BellaLee2007/tinggu/docs/hardware_pinout.md

# 硬件引脚与实物接口

本表于 2026-09-14 更新为当前 ESP32-S3 实物接口；经典 ESP32 的旧 GPIO34/21/22 接法不适用于此版本。物理接线以
`docs/tonight_bringup_wiring.md` 的节点表为准；任何改线都必须同步更新两份文档。

| 模块 | 型号 | ESP32接口 | 电压/供电 | 当前状态与备注 |
|---|---|---|---|---|
| 主控 | ESP32-S3（Arduino选择 ESP32S3 Dev Module） | USB串口 | USB/5 V | USB供电；模拟前端使用ESP32的3.3 V |
| 压电模拟输出 | 压电片＋BAT54S＋TLV9062 | GPIO4 / ADC1_CH3 | GPIO4目标范围0～3.3 V | 100 kΩ限流、BAT54S钳位、1.65 V偏置、1倍缓冲、2.2 kΩ串联保护；不使用输出分压 |
| IMU | 模块丝印MPU-6050，实测WHO_AM_I=0x70（MPU-6500兼容芯片） | SDA=GPIO17，SCL=GPIO15 | 3.3 V | 地址0x68；INT/XDA/XCL不接；固件按MPU-6500报告 |
| 模拟前端 | TLV9062（芯片第二行`ZFT9G3`为追踪码） | 输出经2.2 kΩ串联接GPIO4 | 3.3 V | 8脚=3.3 V、4脚=GND；B路缓冲基准，A路缓冲压电信号；轨到轨输入/输出 |
| ARM按钮 | 待选 | 默认禁用，`ARM_BUTTON_PIN=-1` | 3.3 V逻辑 | 可只使用C#或串口ARM |
| OLED | SSD1306，128×64，四针I²C | SDA=GPIO8，SCL=GPIO9（Wire1） | VCC=3.3 V，GND共地 | 独立于MPU总线；自动探测0x3C/0x3D；端侧固件已实现，未接不阻断采集 |
| 电磁撞针 | 型号待确认 | **不连接ESP32** | 独立电源和控制器 | 记录电压、电流、档位、冲程、头部尺寸和固定距离 |

## 硬件同学必须补齐

- ESP32、MPU、OLED和压电调理板的完整丝印照片；
- 压电ADC静止偏置、空闲噪声、轻敲峰值和是否削顶；
- 撞针控制器的档位或脉宽设置，以及每次实验是否完全相同；
- MPU方向、安装胶层、线长、压电位置和铁板尺寸；
- 撞针通电但不接触铁板时，压电是否因电磁干扰误触发。
