BellaLee2007/tinggu/docs/decision_log.md

# 技术决策记录

| 日期 | 决策 | 原因 | 后续验证 |
|---|---|---|---|
| 2026-08-28 | 撞针由外部按钮/控制器触发，ESP32不控制其功率回路 | 最终敲击结构尚未冻结，优先降低嵌入式和电气风险 | 第3天前冻结型号、安装位置和激励设置 |
| 2026-08-28 | 保留验证固件，另建`tinggu_edge_runtime` | 防止双核和端侧算法破坏已验证的数据链路 | 两套固件分别编译和验收 |
| 2026-08-28 | Core 0采集、Core 1处理，使用两个固定缓冲区和Queue传递所有权 | 保证DMA采样不被FFT、串口和显示阻塞 | 检查任务核心、队列溢出和丢点率 |
| 2026-08-28 | 模型未交付前固定返回`MODEL_UNTRAINED` | 禁止用臆造阈值输出松紧结论 | golden vectors通过后才能替换模型接口 |
| 2026-08-28 | 初始512点FFT，采样率从2/5/10/20 kHz实测选择 | 报告要求根据实际频段校准 | 主峰<0.4采样率且相邻采样率主频偏差<2% |
| 2026-09-14 | 新增20260913全量清洗数据决策树的独立候选移植，暂不切换正式LDA；采样与阈值保持原样 | 新树为14特征，仓库缺对应特征实现、明确映射和golden vectors，禁止猜测接入 | 树遍历2087组与12叶路径测试通过、ESP32-S3编译通过；端到端验证待补交代码，候选保持MODEL_UNTRAINED |
| 2026-09-14 | OLED冻结SSD1306 128×64四针I²C，3.3V，Wire1 SDA8/SCL9；仅loop刷新、结果保持至下一次测量 | MPU仍独占Wire SDA17/SCL15；屏幕缺失不影响采集；不改变模型、特征、阈值和采样率 | ESP32-S3编译及显示状态检查；接屏实测待完成 |
| 2026-09-14 | 核对92d65d5训练脚本，确认树类别映射并将候选推断输入转换float32；仍不切换正式模型 | 新脚本只读取预计算14维特征表，缺波形提取程序与golden；禁止猜测公式 | 2087组树遍历测试通过；等待生成training_dataset_20260911.csv的脚本 |
| 2026-09-14 | 暂不启用新树：新增特征脚本ab53542与现有模型/本地波形不能复现节点分布 | 289条回放命中116条；根节点左分支应124条实际33条；Python/C++分类一致，排除树移植差异 | 已生成逐事件14维特征及节点对照；等待实际训练特征表与配套版本，不更改正式LDA/OLED |
| 2026-09-15 | 采用4859fa6原始train_waveform_14features脚本，切换正式端侧为14维自定义double树，保留OLED | 289条23节点样本数及多数类全匹配；原始波形14维Python/C++一致、分类0差异；旧250Hz/300ms脚本不配套 | 已完成主机golden及EventBuffer适配验证，上电加入真实波形自检；实物测量待验收 |
| 2026-09-15 | 硬锁2kHz压电/1kHz MPU，整段变长事件1400–2600行、Hann后补零至最多4096，100Hz分频；取代240ms LDA特征 | 原始模型对事件长度和频域定义敏感，旧固定900ms不可直接复用；触发按V16三活动样本确认、最小阈值20，50ms双传感器安静后允许结束 | CSV原数据不修改；现场核对#MODEL_FEATURES及MPU丢点；MPU6500 ACCEL_CONFIG2=0x01与采集版一致 |
| 2026-09-15 | 从已完全匹配的训练波形恢复叶节点各类计数，沿用三敲概率均值与0.50门限 | 原JSON只有pred+n；恢复计数经全部节点n和argmax验证，不重训、不虚构100%置信度 | 单元测试包含三类平票→UNCERTAIN、单一路无效→MODEL_UNTRAINED；频率并非独立测试准确率 |
