BellaLee2007/tinggu/tools/TingguSignalWorkbench/使用说明.md

# 听固双传感器敲击验证工作台

这套工具只判断压电片和 MPU-6050 的信号是否清晰、完整、可重复，不直接给出螺丝“松/紧”结论。

## 第一次使用

1. 打开 `firmware/tinggu_signal_validator/tinggu_signal_validator.ino`，只检查文件最上面的 `PIEZO_ADC_PIN`、`MPU_SDA_PIN`、`MPU_SCL_PIN`。地址保留 `0` 即可自动检测。
2. 在 Arduino IDE 中选择普通 ESP32 和对应串口，上传固件。
3. 关闭 Arduino 串口监视器，因为一个串口不能同时被两个程序占用。
4. 双击 `TingguSignalWorkbench.exe`，选择 COM 口并点“连接”。
5. 上电标定的一秒内不要碰铁板。如果刚才动过铁板，等待静止后点“重新标定”。
6. 填写试件编号、松紧描述和敲击方式，点“下一次采集 / ARM”。
7. 状态显示“已布防，可以敲击”后，只敲一次。工具会等待约 0.9 秒，接收数据后冻结两张曲线并自动导出 CSV。
8. 看完本次结果后，再点一次“下一次采集 / ARM”，然后进行下一次敲击。

“手动采集”用于不敲击也强制抓取一秒数据，主要检查静止噪声。图表可框选缩放，双击恢复全图。

## 导出位置

- 单次波形：`data/signal_validator/event_*.csv`
- 每次一行的指标汇总：`data/signal_validator/summary.csv`

单次 CSV 保留 2000 Hz 时间轴。MPU 只在真正读取到的 1000 Hz 行写值，其他行留空，不进行伪插值。

## 质量判定的含义

- 压电默认要求：不饱和，SNR ≥ 10 dB。
- MPU 默认要求：不饱和，丢点率 < 1%，SNR ≥ 6 dB。
- 两路同时通过才显示“双传感器信号有效”。阈值可在界面修改。
- “窗口截断”表示 900 ms 后振动仍未衰减到噪声阈值以下，需要检查安装、环境干扰，或以后增大采集窗口。

标准化敲击结构完成前，主频、持续时间等结果只能用于确认传感器结构是否可靠，不能据此下松紧结论。
