BellaLee2007/tinggu/firmware/releases/oled_ssd1306_20260914/验证记录.md

# 验证记录

- ESP32-S3，fqbn=esp32:esp32:esp32s3；U8g2=2.36.19。
- 正式端侧编译成功：395892 bytes flash，64992 bytes全局RAM。
- 独立OLED验屏编译成功：351604 bytes flash，24712 bytes全局RAM。
- 主机模拟测试通过：结果保持、迟到PROCESSING消息不覆盖结果、启动新测量清除旧结果、仅变化刷新、屏幕掉线停用显示。
- 两个程序的display_interface.h内容一致；打包源码与编译源码一致。
- 未烧录开发板，未进行实物屏幕/传感器同时工作的验收。
- 正式模型、特征、采样率、质量阈值未改变。
