BellaLee2007/tinggu/firmware/releases/oled_ssd1306_20260914/tinggu_edge_runtime/README.md

# Tinggu edge runtime

这是比赛端侧固件骨架，不替代已经验证可用的 `tinggu_signal_validator`。

## 当前已实现

- 底层 `adc_continuous` DMA保留每个压电ADC原始点；
- MPU-6050原始I2C驱动；
- 采集任务固定到Core 0，分析任务固定到Core 1；
- 两个固定事件缓冲区和FreeRTOS Queue所有权传递；
- 三次外部敲击组成一次测量；
- 质量门控、512点Hann FFT、`f1/tau/Eratio/C`；
- 240 ms固定截窗、40项频谱/时频/相干特征和三分类LDA模型；
- 三次敲击分别推理，再平均三类概率输出最终结果；
- 每敲发送101点降采样预览，供V13桌面端显示波形，不阻塞下一次采集；
- 模型和OLED的独立替换接口；
- 撞针完全外部触发，没有撞针控制GPIO。

## 当前硬件接口

1. 当前ESP32-S3接口为 `PIEZO_ADC_PIN=4`（ADC1_CH3）、`MPU_SDA_PIN=17`、`MPU_SCL_PIN=15`；完整模拟前端见 `docs/tonight_bringup_wiring.md`。
2. 上电标定的一秒内保持铁板静止。
3. 串口发送 `ARM_MEASUREMENT`。每一敲先输出 `PREPARE_STRIKE` 并倒计时2秒，看到 `STRIKE_NOW` 后再按撞针；每一敲单独有5秒等待时间。
4. 当前模型为 `spectral_lda40_20260903`，类别为 `TIGHT/MEDIUM/LOOSE`；最终置信度低于0.50时输出 `UNCERTAIN`。
5. `#STRIKE_RESULT`把满足质量门控的敲击标为A级并计入；未达到A级的尝试立即丢弃并重试当前序号，直到累计3次A级敲击才输出结果。`#HIT_MODEL`输出单敲调试概率，`#MEASUREMENT_RESULT`输出三次A级敲击概率平均后的类别。
   V13桌面端还会解析`#PREVIEW_BEGIN/#PREVIEW_POINT/#PREVIEW_END`，显示每敲降采样波形。
6. 当前模型的同日分组验证准确率约81.8%，仍必须用下一次独立实验验证，不能把它当作最终准确率。
7. `display_interface.h` 已实现 SSD1306 128×64 I²C OLED；安装 U8g2 库（本机验证版本2.36.19），SDA=GPIO8、SCL=GPIO9、VCC=3V3、GND共地，自动探测0x3C/0x3D。使用Wire1独立总线，仅loop执行屏幕传输。接线和测试见 `docs/oled_setup.md`。

## 串口命令

- `ARM_MEASUREMENT`：开始等待三次敲击；
- `ABORT`：中止本次测量；
- `RECALIBRATE`：重新静置标定；
- `STATUS`：输出任务核心、状态、采样率和传感器状态。
