BellaLee2007/tinggu/models/20260913/confusion_matrix_full.png

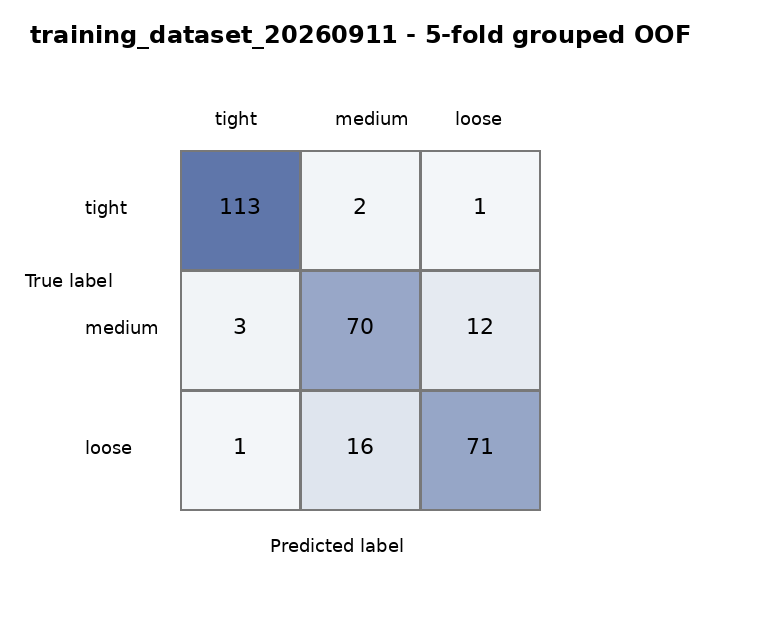
models/20260913/confusion_matrix_full.png
