BellaLee2007/tinggu/models/20260913/confusion_matrix_perfect_strict.png

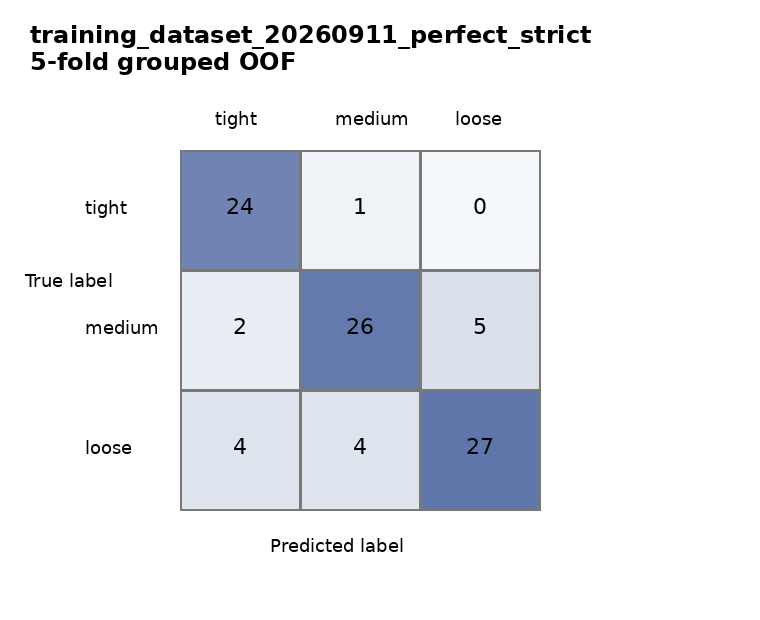
models/20260913/confusion_matrix_perfect_strict.png
