BellaLee2007/tinggu/firmware/releases/oled_ssd1306_20260914/tinggu_edge_runtime/model_parameters.h

#pragma once

// Generated from models/20260903/spectral_lda40_export.json.
// Feature extraction order is frozen; do not reorder these arrays by hand.
static const char TINGGU_MODEL_VERSION[] = "spectral_lda40_20260903";
static const unsigned TINGGU_MODEL_FEATURE_COUNT = 40;
static const unsigned TINGGU_MODEL_CLASS_COUNT = 3;
static const float TINGGU_MODEL_CONFIDENCE_THRESHOLD = 0.50f;

static const char *const TINGGU_MODEL_FEATURE_NAMES[40] = {
  "rm_spec_band_150_200",
  "rm_spec_band_200_250",
  "rm_spec_band_250_400",
  "rm_spec_band_60_100",
  "rm_spec_cep_03",
  "rm_spec_cep_06",
  "rm_spec_cep_08",
  "rm_spec_cep_09",
  "rm_spec_cep_15",
  "rm_spec_cep_16",
  "rm_tf_t0_100_150",
  "rm_tf_t0_150_200",
  "rm_tf_t0_200_250",
  "rm_tf_t0_5_30",
  "rm_tf_t0_60_100",
  "rm_tf_t1_150_200",
  "rm_tf_t1_250_400",
  "rm_tf_t1_60_100",
  "rm_tf_t2_150_200",
  "rp_spec_band_100_150",
  "rp_spec_band_150_200",
  "rp_spec_band_300_500",
  "rp_spec_cep_02",
  "rp_spec_cep_03",
  "rp_spec_cep_05",
  "rp_spec_cep_07",
  "rp_spec_cep_09",
  "rp_spec_cep_19",
  "rp_tf_t1_100_150",
  "rp_tf_t1_250_500",
  "rp_tf_t2_100_150",
  "rp_tf_t2_5_30",
  "rp_tf_t3_100_150",
  "rp_tf_t3_150_250",
  "rp_tf_t3_5_30",
  "rp_tf_t3_60_100",
  "xfer_coherence_30_60",
  "xfer_logratio_100_150",
  "xfer_logratio_150_200",
  "xfer_logratio_60_100",
};

static const float TINGGU_MODEL_IMPUTER_MEDIAN[40] = {
  0.086686891f, 0.0577367906f, 0.162263728f, 0.234962171f,
  0.885562861f, -0.932165321f, 0.0266282279f, 0.813759559f,
  -0.351437795f, -0.399328163f, 0.116980171f, 0.0944962775f,
  0.0478989077f, 0.0152079045f, 0.228174496f, 0.0486212098f,
  0.157310245f, 0.196841061f, 0.0204528909f, 0.0258772888f,
  0.0282733628f, 0.119010446f, 2.66366889f, 3.63617525f,
  3.59083403f, 1.49292455f, 1.04893707f, -0.105270977f,
  0.0149367788f, 0.121634086f, 0.0178458241f, 0.113140785f,
  0.0130630471f, 0.0185584314f, 0.126587095f, 0.0913513555f,
  0.449819847f, -3.59211676f, -3.76983623f, -3.26365404f,
};

static const float TINGGU_MODEL_SCALER_MEAN[40] = {
  0.111908653f, 0.0760772969f, 0.203329908f, 0.293470724f,
  0.23112501f, -1.09361717f, 0.0983615209f, 1.18083086f,
  -0.542089193f, -0.53712606f, 0.142536822f, 0.113977528f,
  0.0730958253f, 0.064284369f, 0.263709237f, 0.0859672178f,
  0.216987711f, 0.272922653f, 0.0438370508f, 0.0332320034f,
  0.0305933355f, 0.131608067f, 2.84639144f, 3.71637307f,
  3.88418556f, 1.46231196f, 1.16692625f, -0.114095108f,
  0.0237640501f, 0.133206789f, 0.02341767f, 0.130237838f,
  0.015734129f, 0.0223009505f, 0.13672451f, 0.107761989f,
  0.463087407f, -3.72535789f, -3.87210005f, -3.50940092f,
};

static const float TINGGU_MODEL_SCALER_SCALE[40] = {
  0.105139601f, 0.0685172174f, 0.166803748f, 0.203949412f,
  4.01826612f, 2.37360316f, 2.12298831f, 2.5260905f,
  1.71148752f, 1.66486843f, 0.0979880334f, 0.100957166f,
  0.0747222344f, 0.102733162f, 0.155313591f, 0.116668947f,
  0.202746527f, 0.229611797f, 0.0568162581f, 0.0275284892f,
  0.0189503074f, 0.0849177283f, 2.81861408f, 2.79210318f,
  2.77238738f, 2.09935435f, 1.78792176f, 1.44485294f,
  0.0278976613f, 0.0956238431f, 0.022885704f, 0.0982200815f,
  0.0137451118f, 0.0211826244f, 0.0963886115f, 0.0825934304f,
  0.229888637f, 1.26464678f, 1.28878656f, 1.11659362f,
};

static const float TINGGU_MODEL_COEFFICIENTS[120] = {
  0.46241487f, -0.332592727f, -0.02496929f, -0.539963712f, -1.08197829f,
  -0.490729656f, -0.460305897f, 0.737940808f, -0.25063013f, -0.181574244f,
  0.0789907556f, 0.638619076f, -0.797643809f, -0.261794486f, 0.511676948f,
  -0.0519024462f, -0.462716894f, 0.782012553f, 0.0451461219f, -0.0313384308f,
  -0.326158711f, -0.0911190641f, 0.501837543f, -0.167329656f, 0.139568616f,
  -0.0259694659f, 0.205474748f, 0.28731498f, -0.340862324f, 0.117339335f,
  -0.124252065f, -0.128099291f, 0.0760609597f, -0.297144005f, 0.203508443f,
  0.0217206666f, -0.194011783f, 0.20344896f, 0.126800114f, -0.485492804f,
  -0.148614056f, 0.371899918f, -0.0381624615f, 0.355513825f, 0.193816657f,
  0.487030597f, 0.287243771f, -0.448637055f, 0.116637869f, 0.11861136f,
  -0.200462672f, -0.245875772f, 0.149820449f, 0.250678165f, -0.250328465f,
  -0.0795331978f, 0.145401489f, -0.465636136f, -0.094114764f, -0.0292748029f,
  0.147022928f, -0.175578819f, -0.101607646f, -0.384875321f, 0.0814374747f,
  0.315730873f, -0.119986198f, -0.184249524f, -0.128114071f, 0.0405283067f,
  -0.133616053f, -0.151660246f, 0.0680045893f, 0.274917411f, 0.0686933548f,
  0.0479844506f, -0.184333473f, 0.0238173516f, -0.372372247f, 0.340369135f,
  -0.330806934f, -0.0375709141f, 0.0658792396f, 0.197101009f, 0.934049009f,
  0.00870426536f, 0.184473555f, -0.308067672f, 0.141780372f, 0.0672542284f,
  0.125500599f, -0.414620455f, 0.681377194f, 0.0141485956f, -0.276765026f,
  0.137154902f, 0.334463707f, -0.336648875f, 0.050461003f, 0.0633240393f,
  0.189459563f, 0.278162344f, -0.421049275f, 0.57573121f, -0.231140675f,
  -0.300979983f, -0.0909086389f, -0.10999196f, 0.490924593f, -0.165281601f,
  0.269310935f, 0.292107432f, -0.150524194f, 0.0260488756f, -0.284997002f,
  -0.0726807721f, 0.395250136f, -0.238281304f, 0.254042315f, 0.155678f,
};

static const float TINGGU_MODEL_INTERCEPTS[3] = {
  -4.01549934f, -2.02661635f, -2.62603818f,
};
