BellaLee2007/tinggu/firmware/tinggu_edge_runtime/model_selftest.h

#pragma once
#include "waveform_features.h"
// GENERATED board startup golden from one actual training waveform, source extraction unchanged.
static const char TINGGU_SELFTEST_SOURCE[]="event_0002_tight_20260911_160233_309.csv";
static const uint16_t TINGGU_SELFTEST_PIEZO[]={1913,1917,1927,1934,1939,1943,1941,1949,1945,1946,1944,1949,1947,1949,1943,1939,1933,1929,1930,1918,1917,1915,1911,1909,1913,1913,1912,1913,1911,1912,1912,1913,1911,1912,1909,1919,1915,1913,1914,1915,1910,1915,1925,1935,1933,1933,1941,1949,1941,1949,1949,1949,1945,1943,1943,1939,1932,1932,1928,1918,1919,1913,1913,1909,1909,1911,1907,1914,1913,1911,1912,1913,1915,1913,1916,1916,1912,1916,1911,1915,1913,1914,1917,1926,1931,1940,1941,1945,1945,1947,1949,1949,1943,1947,1945,1933,1938,1935,1929,1919,1917,1917,1913,1903,1913,1913,1908,1909,1909,1909,1916,1911,1912,1913,1915,1911,1910,1913,1913,1913,1916,1918,1928,1928,1935,1939,1940,1944,1951,1944,1949,1947,1949,1947,1945,1937,1935,1931,1929,1917,1913,1912,1911,1907,1913,1912,1909,1916,1912,1913,1912,1911,1915,1913,1911,1913,1912,1911,1911,1911,1917,1917,1928,1928,1940,1935,1944,1943,1943,1942,1949,1945,1949,1944,1946,1939,1938,1931,1930,1917,1917,1917,1913,1909,1914,1915,1911,1911,1919,1910,1903,1916,1919,1911,1915,1915,1917,1799,1799,2159,1443,2039,2019,1547,1373,2028,1885,1834,2301,2351,2255,2715,2586,1991,2183,1915,1583,1720,1801,1581,1715,1867,1749,1764,1911,1769,1682,1976,1771,1961,2220,2095,1976,2087,1899,1737,1785,1871,1822,1911,1919,1829,1804,1813,1773,1847,1862,1885,2089,2237,2272,2279,2235,1965,1909,1818,1780,1775,1813,1782,1774,1829,1815,1829,1867,1906,2005,2077,2167,2165,2173,2085,1995,1864,1759,1711,1757,1775,1811,1853,1877,1873,1901,1949,1965,1989,2015,2027,2057,2045,203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
struct TingguStartupGolden : TingguWaveform14::Waveform {
 unsigned count()const override{return sizeof(TINGGU_SELFTEST_PIEZO)/sizeof(TINGGU_SELFTEST_PIEZO[0]);}
 double timeMs(unsigned i)const override{return -98.5 + i*.5;}
 double delta(unsigned i)const override{return double(TINGGU_SELFTEST_PIEZO[i])-1917.0;}
 TingguWaveform14::MpuMoments mpu()const override{
  TingguWaveform14::MpuMoments m;
  for(const auto &v:TINGGU_SELFTEST_MPU){
   double ax=round(v[0]/2048.0*1e7)/1e7,ay=round(v[1]/2048.0*1e7)/1e7,az=round(v[2]/2048.0*1e7)/1e7;
   double gx=round(v[3]/32.8*1e6)/1e6,gy=round(v[4]/32.8*1e6)/1e6,gz=round(v[5]/32.8*1e6)/1e6;
   ++m.validRows;m.acceleration.add(sqrt(ax*ax+ay*ay+az*az));m.gyroscope.add(sqrt(gx*gx+gy*gy+gz*gz));
  }return m;
 }
};
inline bool tingguModelStartupSelfTest(TingguWaveform14::Workspace &workspace){
 TingguStartupGolden view;double got[14];if(!TingguWaveform14::extract(view,workspace,got))return false;
 for(unsigned i=0;i<14;++i)if(fabs(got[i]-TINGGU_SELFTEST_FEATURES[i])>1e-6+1e-7*fabs(TINGGU_SELFTEST_FEATURES[i]))return false;
 int expected=tingguTreeLeaf(TINGGU_SELFTEST_FEATURES),actual=tingguTreeLeaf(got);
 return expected>=0 && actual==expected;
}
