BellaLee2007/tinggu/(commit log)

2026-08-28 feat: add dual-sensor signal validation workbench
2026-09-03 feat: add 20260903 looseness models and training scripts
    [spectral_lda40_selected_features.csv, spectral_lda_selected_features.csv]
2026-09-04 feat: deploy LDA40 model to ESP32-S3 edge runtime
2026-09-04 fix: move ESP32-S3 DMA input to ADC1
    [tinggu_edge_runtime.ino]
2026-09-04 feat: guide and validate each strike in three-hit flow
2026-09-14 feat: publish SSD1306 OLED firmware release and wiring README
2026-09-15 feat: integrate 14-feature waveform decision tree into edge runtime
    Replace the LDA model_parameters.h path with the waveform decision-tree runtime:
    - tree_model_parameters.h + waveform_features.h (14-dim double, 2kHz piezo / 1kHz MPU)
    - tree_event_adapter.h + model_selftest.h (embedded real-waveform power-on selftest)
    - model_interface.h / display_interface.h / tinggu_edge_runtime.ino wired to the tree
    - serial #MODEL_FEATURES + #MODEL_SELFTEST, three-strike A-grade majority w/ 0.50 gate
    - docs: model_integration_20260914/15, oled_setup, wiring; verification JSON + host tests
    [display_interface.h, model_interface.h, model_selftest.h, tinggu_edge_runtime.ino, tree_event_adapter.h]
2026-09-24 chore: remove 20260903 model artifacts
    [spectral_lda40_selected_features.csv, spectral_lda_selected_features.csv]
